Abidzuk/Proiect-Practica-6V-LDO-with-1V2-switch/6V LDO/EasyEDA/Front.png

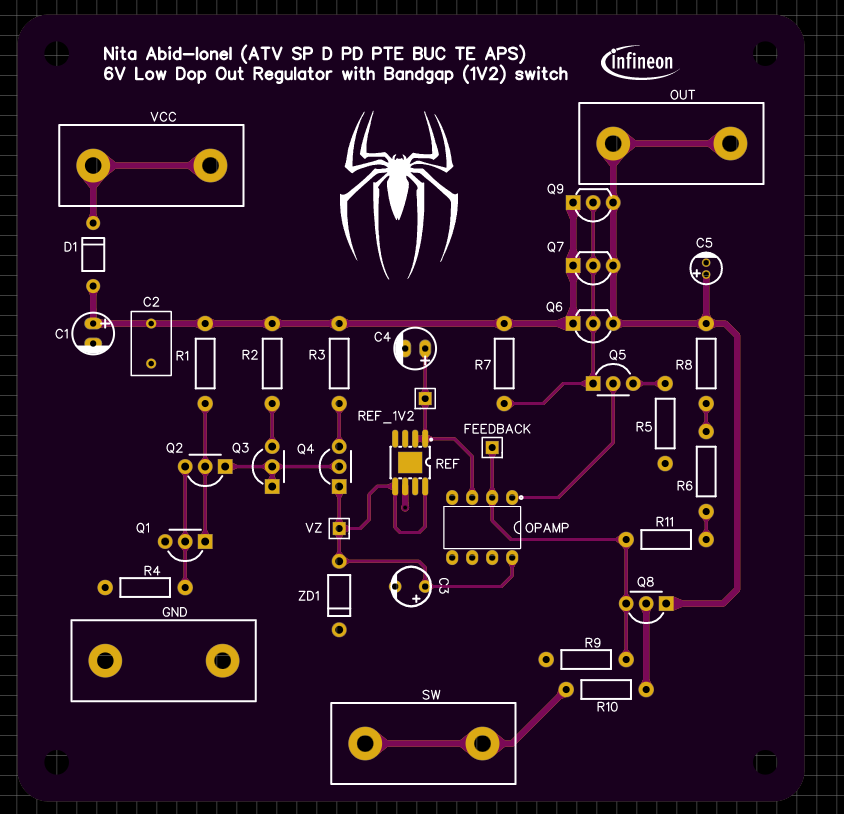
6V LDO/EasyEDA/Front.png
