Abidzuk/Proiect-Practica-6V-LDO-with-1V2-switch/6V LDO/EasyEDA/BOM_LDO-6V-switch_2026-07-30.csv

ID | Name | Designator | Footprint | Quantity | Manufacturer Part | Manufacturer | Supplier | Supplier Part | Price
1 | 10u | C1,C4 | CAP-D5.0×F2.5 | 2
2 | 10n | C2 | RAD-0.2 | 1
3 | 1u | C3 | CAP-D5.0×F2.0 | 1
4 | 3.3u | C5 | CAP-D4.0-F1.5 | 1
5 | 1N5817G | D1 | DO-41_BD2.8-L4.2-P8.00-D0.7-FD | 1 | 1N5817G | onsemi(安森美) | LCSC | C898906 | 0.137
6 | HDR-M-2.54_1x1 | FEEDBACK,REF_1V2,VZ | HDR-M-2.54_1X1 | 3 |  |  | LCSC | C81276 | 0.013
7 | GND | GND | BANANA | 1
8 | LM358P | OPAMP | DIP-8_L9.4-W6.4-P2.54-LS9.1-BL | 1 | LM358P | TI(德州仪器) | LCSC | C5213 | 0.21
9 | OUT | OUT | BANANA | 1
10 | BC547B | Q1,Q2,Q5,Q8 | TO-92-3_L4.8-W3.7-P2.54-L | 4 | BC547B | LGE(鲁光) | LCSC | C713613 | 0.05
11 | BC557B | Q3,Q4 | TO-92-3_L4.8-W3.7-P2.54-L | 2 | BC557B-TA | CJ(江苏长电/长晶) | LCSC | C2093
12 | 2N2907 | Q6,Q7,Q9 | TO-92-3_L4.8-W3.7-P2.54-R | 3 | 2N2907A | ST(先科) | LCSC | C118537 | 0.045
13 | 1k | R1 | R_AXIAL-0.4 | 1
14 | 100 | R2,R3,R4 | R_AXIAL-0.4 | 3
15 | 2.2k | R5,R7 | R_AXIAL-0.4 | 2
16 | 5.6k | R6 | R_AXIAL-0.4 | 1
17 | 33k | R8 | R_AXIAL-0.4 | 1
18 | 10k | R9 | R_AXIAL-0.4 | 1
19 | 50k | R10 | R_AXIAL-0.4 | 1
20 | 400 | R11 | R_AXIAL-0.4 | 1
21 | TLS205B0EJV | REF | PG-DSO-8_L4.9-W3.9-P1.27-LS6.0-BL-EP | 1 | TLS205B0EJV | Infineon(英飞凌) | LCSC | C540255
22 | SW | SW | BANANA | 1
23 | VCC | VCC | BANANA | 1
24 | 1N4734A | ZD1 | DO-41_BD2.4-L4.7-P8.70-D0.9-RD | 1 | 1N4734A | ST(先科) | LCSC | C2537 | 0.03
