Abidzuk/Proiect-Practica-6V-LDO-with-1V2-switch/6V LDO/LTSpice/Schematic.asc

C1: cap; 10µ
C2: cap; 10n
C3: cap; 1µ
C4: cap; 10µ
C5: cap; 3.3µ
D1: diode; 1N5817
D2: zener; 1N750
Q1: npn; BC547B
Q2: npn; BC547B
Q3: pnp; BC557B
Q4: pnp; BC557B
Q5: npn; BC547B
Q6: pnp; 2N2907
Q7: pnp; 2N2907
Q8: npn; BC547B
Q9: pnp; 2N2907
R1: res; 1k
R2: res; 100
R3: res; 100
R4: res; 100
R5: res; 2.2k
R6: res; 60
R7: res; 2.2k
R8: res; 39.2k
R9: res; 10k
R10: res; 50k
U2: LT1763
U3: LTC1050
V1: voltage; 6.5
V2: voltage; 0
Named nets: 0, in, out, ref, da
.op
.dc V1 0 15 0.1
.temp 25
.dc I1 1m 100m 1m
