Abidzuk/Proiect-Practica-6V-LDO-with-1V2-switch/6V LDO/LTSpice/Simlation Results/measurements.xlsx

We make power smart, together. |  |  |  | Low Drop-Out Regulator with Switch (VQ2 = Vbg) Datasheet
Minimum Operating Voltage - Minimum Opening Voltage - Output Voltage - Line Regulation - Load Regulation
Simulation Results |  |  |  |  |  |  | Measurements Results |  |  |  |  |  |  |  | Testing Results
 |  | Values |  |  |  | Test |  |  | Values |  |  |  |  | Test |  |  | Values |  |  |  | Test
Parameter | Symbol | Cold | Ambient | Hot | Unit | Condition | Parameter | Symbol | Cold | Ambient | PCB-Ambient | Hot | Unit | Condition | Parameter | Symbol | Cold | Ambient | Hot | Unit | Condition
Minimum Operating Voltage | VIN,min |  | 6.300 |  | V | IOUT: 1mA | Minimum Operating Voltage | VIN,min |  | 6.350 |  |  | V | IOUT: 1mA | Minimum Operating Voltage | VIN,min |  |  |  | V | IOUT: 1mA
Minimum Opening Voltage | VIN,opening |  | 2.200 |  | V | IOUT: 1mA | Minimum Opening Voltage | VIN,opening |  | 2.500 |  |  | V | IOUT: 1mA | Minimum Opening Voltage | VIN,opening |  |  |  | V | IOUT: 1mA
Minimum Operating Voltage | VIN,min |  | 6.300 |  | V | IOUT: 10mA | Minimum Operating Voltage | VIN,min |  | 6.430 |  |  | V | IOUT: 10mA | Minimum Operating Voltage | VIN,min |  |  |  | V | IOUT: 10mA
Minimum Opening Voltage | VIN,opening |  | 2.200 |  | V | IOUT: 10mA | Minimum Opening Voltage | VIN,opening |  | 2.500 |  |  | V | IOUT: 10mA | Minimum Opening Voltage | VIN,opening |  |  |  | V | IOUT: 10mA
Output Voltage | VOUT |  | 6.00771 |  | V | IOUT: 1 mA VIN: VIN,min: 6,5V | Output Voltage | VOUT |  | 5.9860 |  |  | V | IOUT: 1 mA VIN: VIN,min | Output Voltage | VOUT |  |  |  | V | IOUT: 1 mA VIN: VIN,min
Output Voltage | VOUT |  | 6.00771 |  | V | IOUT: 1 mA VIN: 15 V | Output Voltage | VOUT |  | 5.9870 |  |  | V | IOUT: 1 mA VIN: 15 V | Output Voltage | VOUT |  |  |  | V | IOUT: 1 mA VIN: 15 V
Output Voltage | VOUT |  | 6.00771 |  | V | IOUT: 10 mA VIN: VIN,min: 6,5V | Output Voltage | VOUT |  | 5.9880 |  |  | V | IOUT: 10 mA VIN: VIN,min | Output Voltage | VOUT |  |  |  | V | IOUT: 10 mA VIN: VIN,min
Output Voltage | VOUT |  | 6.00771 |  | V | IOUT: 10 mA VIN: 15 V | Output Voltage | VOUT |  | 5.9860 |  |  | V | IOUT: 10 mA VIN: 15 V | Output Voltage | VOUT |  |  |  | V | IOUT: 10 mA VIN: 15 V
Output Voltage | VOUT |  | 6.00771 |  | V | IOUT: IOUT(max) 100mA VIN: VIN,min: 6,5V | Output Voltage | VOUT |  | 5.9560 |  |  | V | IOUT: IOUT(max) VIN: VIN,min | Output Voltage | VOUT |  |  |  | V | IOUT: IOUT(max) VIN: VIN,min
Line Regulation | ΔVOUT |  | 1.10892e-07 |  | mV | ΔVIN: VIN,min - 15 V IOUT: 1 mA | Line Regulation | ΔVOUT |  | 0.001 |  |  | mV | ΔVIN: VIN,min - 15 V IOUT: 1 mA | Line Regulation | ΔVOUT |  |  |  | V | ΔVIN: VIN,min - 15 V IOUT: 1 mA
Load Regulation | ΔVOUT |  | 0.00000 |  | mV | VIN: VIN,min: 6,5V ΔIOUT: 1 mA - 100mA | Load Regulation | ΔVOUT |  | 0.029 |  |  | mV | VIN: VIN,min ΔIOUT: 1 mA - IOUT(max) | Load Regulation | ΔVOUT |  |  |  | V | VIN: VIN,min ΔIOUT: 1 mA - IOUT(max)
Dropout Voltage - GND Current
Simulation Results |  |  |  |  |  |  | Measurements Results |  |  |  |  |  |  |  | Testing Results
 |  | Values |  |  |  | Test |  |  | Values |  |  |  |  | Test |  |  | Values |  |  |  | Test
Parameter | Symbol | Cold | Ambient | Hot | Unit | Condition | Parameter | Symbol | Cold | Ambient | PCB-Ambient | Hot | Unit | Condition | Parameter | Symbol | Cold | Ambient | Hot | Unit | Condition
Dropout Voltage | VDR |  | 300.000 |  | mV | IOUT: 1 mA VIN: VOUT,nom: 6V | Dropout Voltage | VDR |  | 350.00 |  |  | V | IOUT: 1 mA VIN: VOUT,nom | Dropout Voltage | VDR |  |  |  | V | IOUT: 1 mA VIN: VOUT,nom
Dropout Voltage | VDR |  | 300.000 |  | mV | IOUT: 10 mA VIN: VOUT,nom: 6V | Dropout Voltage | VDR |  | 430.00 |  |  | V | IOUT: 10 mA VIN: VOUT,nom | Dropout Voltage | VDR |  |  |  | V | IOUT: 10 mA VIN: VOUT,nom
Dropout Voltage | VDR |  | 500.000 |  | mV | IOUT: IOUT(max): 100 mA VIN: VOUT,nom: 6V | Dropout Voltage | VDR |  | 580.00 |  |  | V | IOUT: IOUT(max) VIN: VOUT,nom | Dropout Voltage | VDR |  |  |  | V | IOUT: IOUT(max) VIN: VOUT,nom
GND Pin Current | IGND |  | 0.711 |  | mA | VIN: VIN,min: 6,5V IOUT: IOUT(max): 100mA | GND Pin Current | IGND |  | 16.00 |  |  | mA | VIN: VIN,min IOUT: IOUT(max) | GND Pin Current | IGND |  |  |  | mA | VIN: VIN,min IOUT: IOUT(max) | 5
GND Pin Current | IGND |  | 0.719 |  | mA | VIN: VIN,min: 6,5V IOUT: 1 mA | GND Pin Current | IGND |  | 16.00 |  |  | mA | VIN: VIN,min IOUT: 1 mA | GND Pin Current | IGND |  |  |  | mA | VIN: VIN,min IOUT: 1 mA
GND Pin Current | IGND |  | 0.719 |  | mA | VIN: VIN,min: 6,5V IOUT: 10mA | GND Pin Current | IGND |  | 17.00 |  |  | mA | VIN: VIN,min IOUT: 10mA | GND Pin Current | IGND |  |  |  | mA | VIN: VIN,min IOUT: 10mA
Output Current Limit
Simulation Results |  |  |  |  |  |  | Measurements Results |  |  |  |  |  |  |  | Testing Results
 |  | Values |  |  |  | Test |  |  | Values |  |  |  |  | Test |  |  | Values |  |  |  | Test
Parameter | Symbol | Cold | Ambient | Hot | Unit | Condition | Parameter | Symbol | Cold | Ambient | PCB-Ambient | Hot | Unit | Condition | Parameter | Symbol | Cold | Ambient | Hot | Unit | Condition
Output Current Limit | IQ,limit |  | 284.84 |  | mA | VIN: VIN,min: 6,5V VOUT: 0 V | Output Current Limit | IQ,limit |  | 320.00 |  |  | mA | VIN: VIN,min VOUT: 0 V | Output Current Limit | IQ,limit |  |  |  | mA | VIN: VIN,min VOUT: 0 V
Output Current Limit | IQ,limit |  | 261.75 |  | mA | VIN: VQ,nom+1V: 7V VOUT: VOUT-0.1V: 5.9V | Output Current Limit | IQ,limit |  | 253.00 |  |  | mA | VIN: VQ,nom+1V VOUT: VOUT-0.1V | Output Current Limit | IQ,limit |  |  |  | mA | VIN: VQ,nom+1V VOUT: VOUT-0.1V
Switch (VQ=Vbg)
Simulation Results |  |  |  |  |  |  | Measurements Results |  |  |  |  |  |  |  | Testing Results
 |  | Values |  |  |  | Test |  |  | Values |  |  |  |  | Test |  |  | Values |  |  |  | Test
Parameter | Symbol | Cold | Ambient | Hot | Unit | Condition | Parameter | Symbol | Cold | Ambient | PCB-Ambient | Hot | Unit | Condition | Parameter | Symbol | Cold | Ambient | Hot | Unit | Condition
Output Voltage 2 | VOUT |  | 1.231 |  | V | IOUT: 1 mA VIN: VIN,min:3.4V | Output Voltage 2 | VOUT |  | 1.2230 |  |  | V | IOUT: 1 mA VIN: VIN,min 3.4 | Output Voltage 2 | VOUT |  |  |  | V | IOUT: 1 mA VIN: VIN,min
Output Voltage 2 | VOUT |  | 1.231 |  | V | IOUT: 1 mA VIN: 15 V | Output Voltage 2 | VOUT |  | 1.2430 |  |  | V | IOUT: 1 mA VIN: 15 V | Output Voltage 2 | VOUT |  |  |  | V | IOUT: 1 mA VIN: 15 V
Output Voltage 2 | VOUT |  | 1.231 |  | V | IOUT: 10 mA VIN: VIN,min:3.4V | Output Voltage 2 | VOUT |  | 1.2230 |  |  | V | IOUT: 10 mA VIN: VIN,min 3.4 | Output Voltage 2 | VOUT |  |  |  | V | IOUT: 10 mA VIN: VIN,min
Output Voltage 2 | VOUT |  | 1.231 |  | V | IOUT: 10 mA VIN: 15 V | Output Voltage 2 | VOUT |  | 1.2280 |  |  | V | IOUT: 10 mA VIN: 15 V | Output Voltage 2 | VOUT |  |  |  | V | IOUT: 10 mA VIN: 15 V
Line Regulation | ΔVOUT |  | 0.000313315 |  | mV | ΔVIN: VIN,min:3.4V - 15 V IOUT: 1 mA | Line Regulation | ΔVOUT |  | 0.001 |  |  | mV | ΔVIN: VIN,min - 15 V IOUT: 1 mA | Line Regulation | ΔVOUT |  |  |  | mV | ΔVIN: VIN,min - 15 V IOUT: 1 mA
Load Regulation | ΔVOUT |  | 1.087 |  | mV | VIN: VIN,min:3.4V ΔIOUT: 1 mA - IOUT(max) | Load Regulation | ΔVOUT |  | 0.005 |  |  | mV | VIN: VIN,min 3.4 ΔIOUT: 1 mA - IOUT(max) | Load Regulation | ΔVOUT |  |  |  | mV | VIN: VIN,min ΔIOUT: 1 mA - IOUT(max)
GND Pin Current | IGND |  | 0.617 |  | mA | VIN: VIN,min:3.4V IOUT: IOUT(max) | GND Pin Current | IGND |  | 7 |  |  | mA | VIN: VIN,min IOUT: IOUT(max) | GND Pin Current | IGND |  |  |  | mA | VIN: VIN,min IOUT: IOUT(max)
GND Pin Current | IGND |  | 0.635 |  | mA | VIN: VIN,min:3.4V IOUT: 1 mA | GND Pin Current | IGND |  | 8 |  |  | mA | VIN: VIN,min IOUT: 1 mA | GND Pin Current | IGND |  |  |  | mA | VIN: VIN,min IOUT: 1 mA
 |  |  |  |  |  |  |  | 3k limit
