Abidzuk/Proiect-Practica-6V-LDO-with-1V2-switch/6V LDO/LTSpice/Simlation Results/Loard_Regulation.png

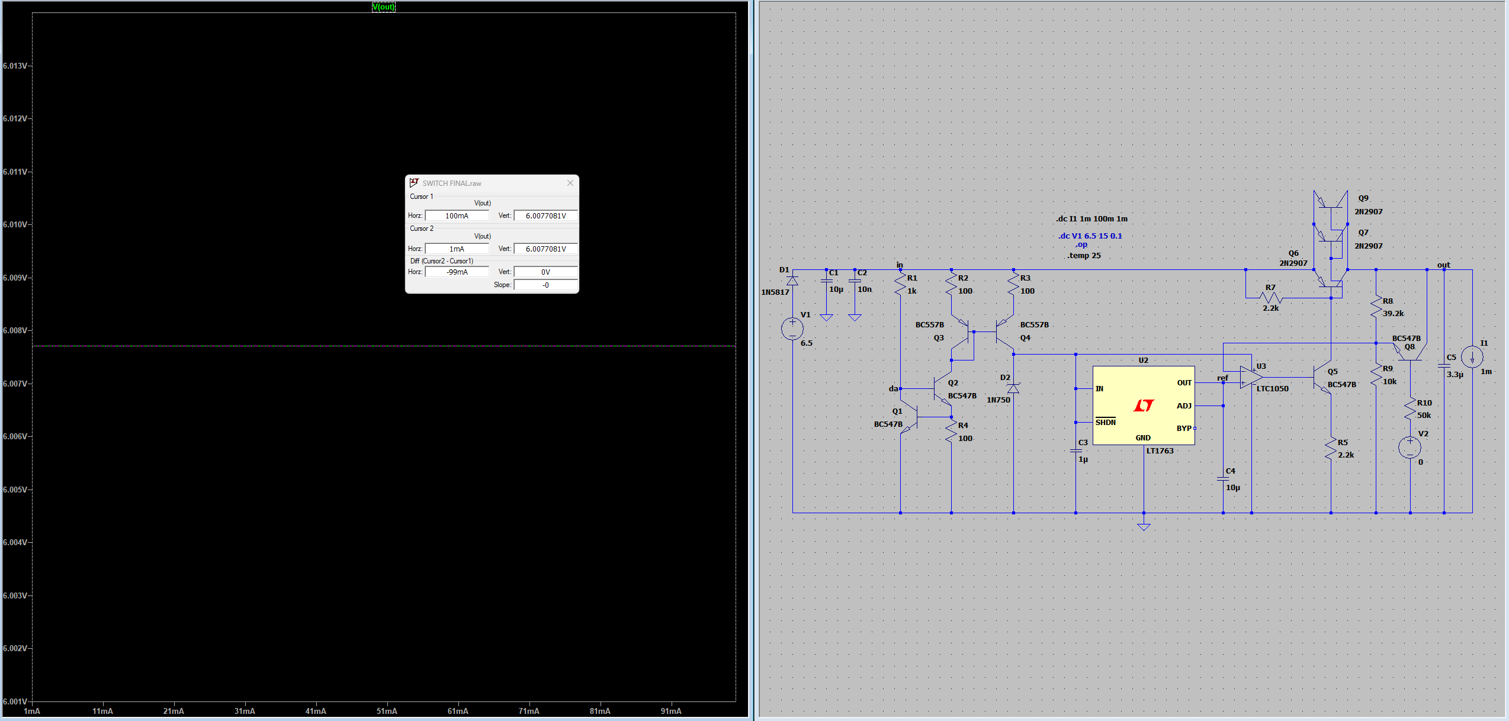
6V LDO/LTSpice/Simlation Results/Loard_Regulation.png
