Abidzuk/Proiect-Practica-6V-LDO-with-1V2-switch/6V LDO/LTSpice/Simlation Results/VDR_1mA.png

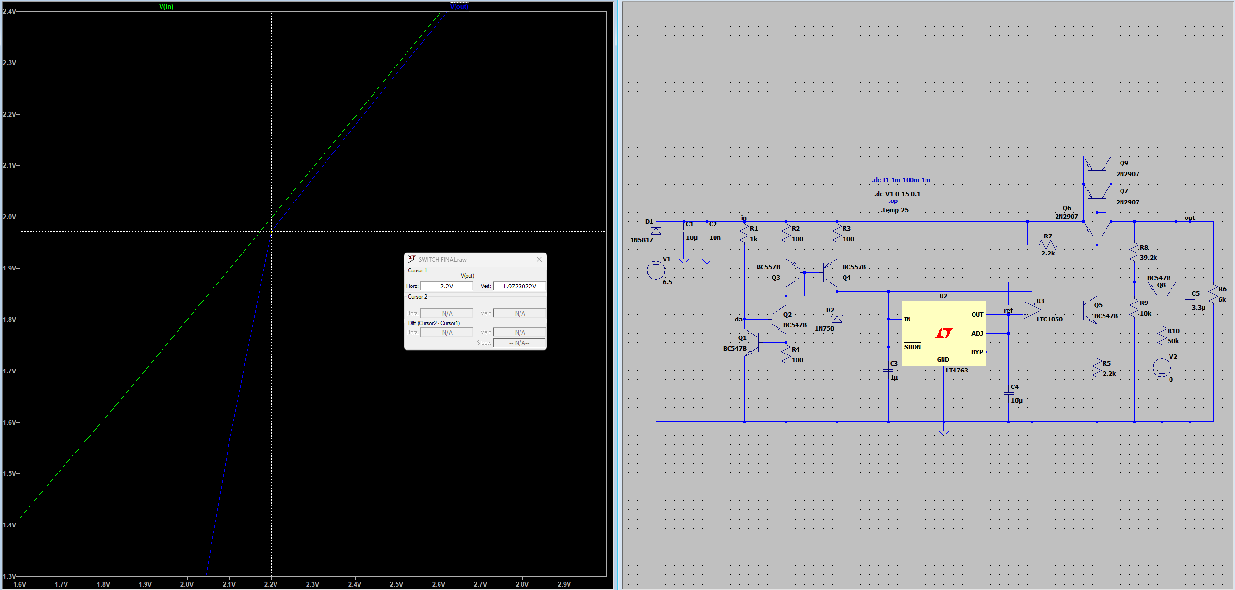
6V LDO/LTSpice/Simlation Results/VDR_1mA.png
